growpro-project/LI-190-PAR-Meter/cad/stl/li-190.stl

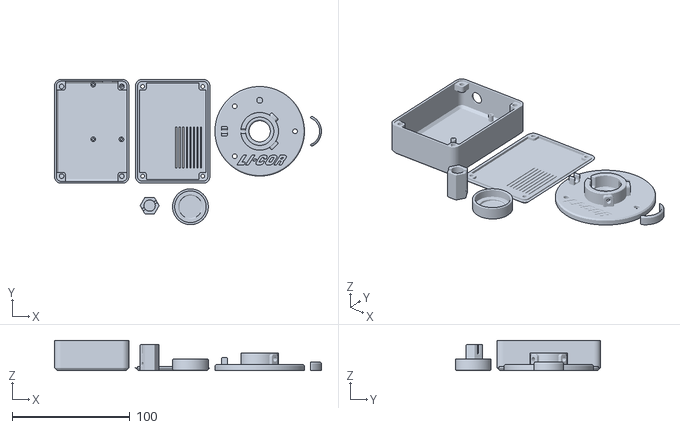
[picture p7: CAD file, 2026-10-10]
cad/stl/li-190.stl
226.7 x 123.4 x 25.6
